danielLelescu/stitchmeter/assets/G25_Slides.pdf

EPFL — CONCEPTION DE MÉCANISMES II

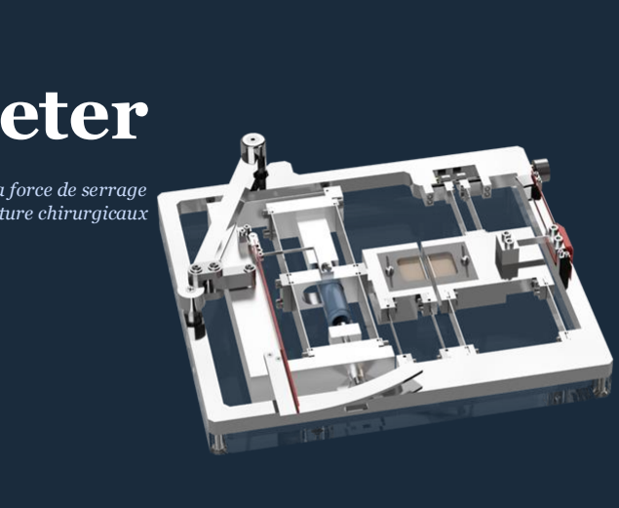
[picture p1: figure]

# StitchMeter

## Dispositif low-tech de mesure de la force de serrage et de la résistance des points de suture chirurgicaux

## Soutenance finale — Groupe 25

### Lucas De Boi · Honoré Specq · Daniel Lelescu

### Lilian Gardon · Titouan Beaux

Encadrement : Dr Simon Henein

20 mai 2026

# Notre but

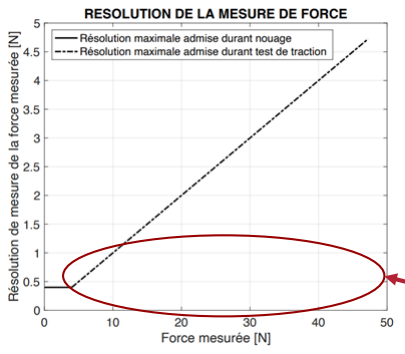
[picture p2: figure]
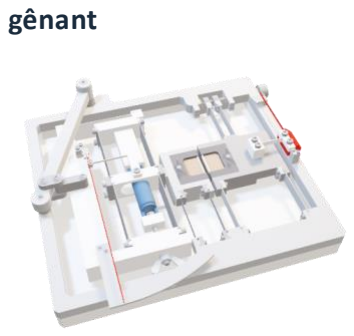
[picture p3: figure]
gênant

## On veut être ici

## - Cahier des charges

## - ΔFr < 10% Fmesure

## - Notre but

## - Résolution aussi fine que possible - Minimisation de toute erreur possible

## - Avantages: - Excellente résolution et précision - Lecture plus confortable, régulière et exploitable - Inconvénient: - dimensionnement stricte et encombrement plus

# Architecture générale du StitchMeter

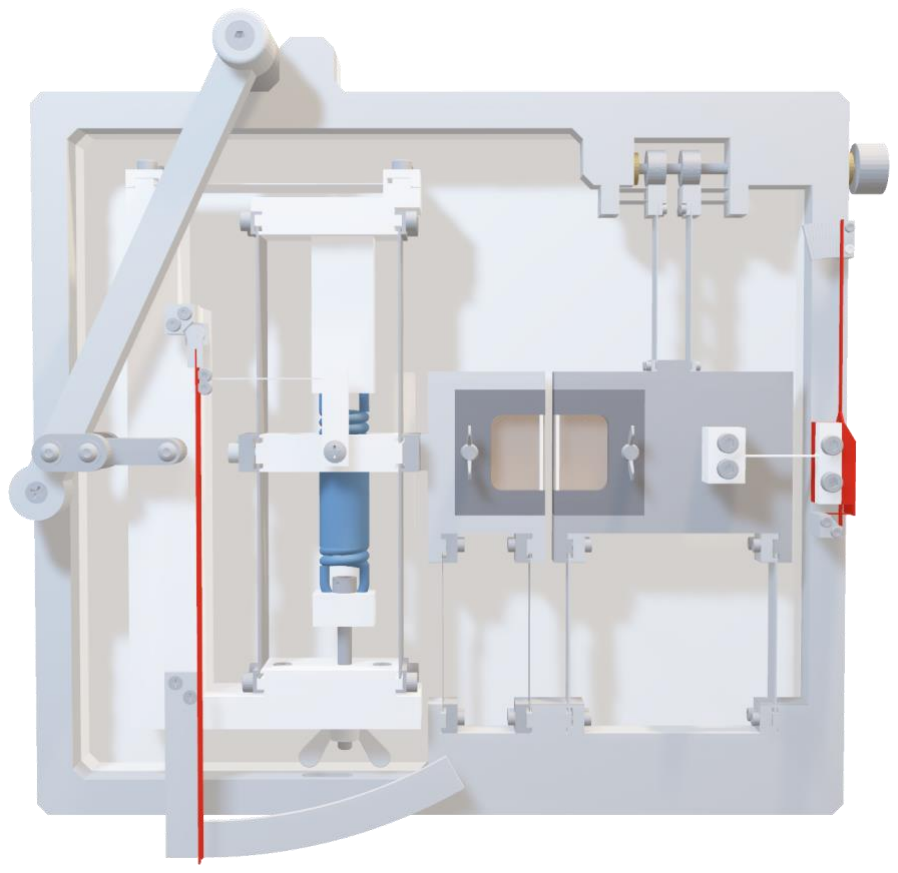
[picture p4: figure]

## Découplage des deux phases

## - Avantages - limite les interactions parasites entre les deux mesures - chaque phase peut être dimensionnée séparément selon son besoin principal - Inconvénient - plus encombrant et comporte deux sous-systèmes à intégrer

# Architecture générale du StitchMeter

Phase II | Phase I

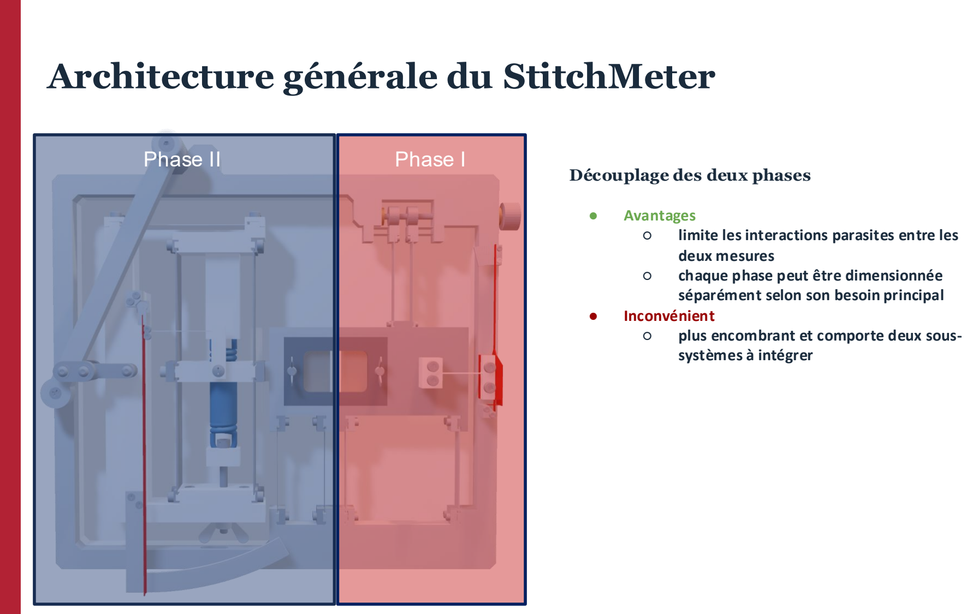
[picture p5: page 4]

## Découplage des deux phases

## - Avantages - limite les interactions parasites entre les deux mesures - chaque phase peut être dimensionnée séparément selon son besoin principal - Inconvénient - plus encombrant et comporte deux sous-systèmes à intégrer

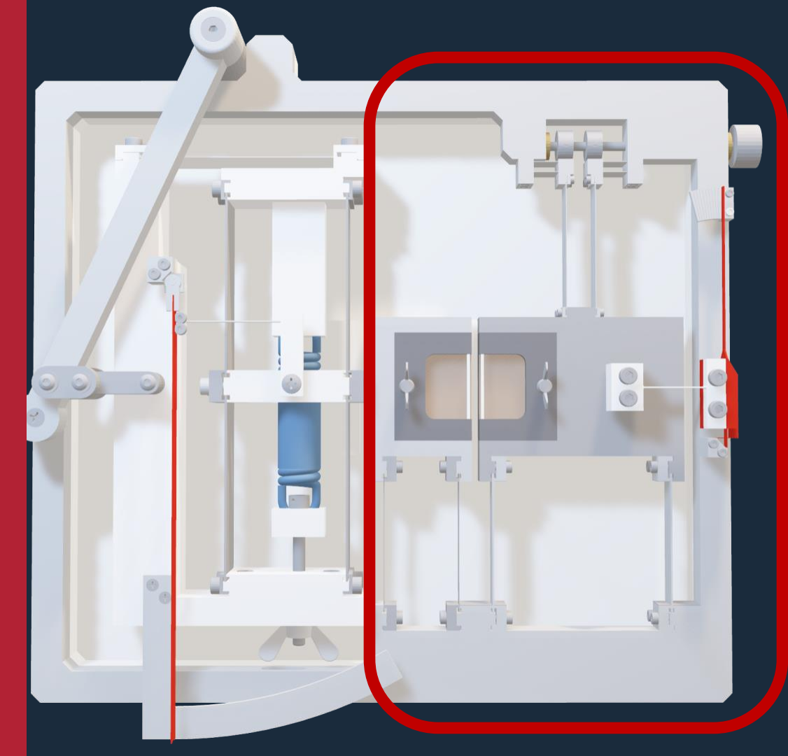
[picture p6: figure]

# Phase I

# Phase I

## Butées

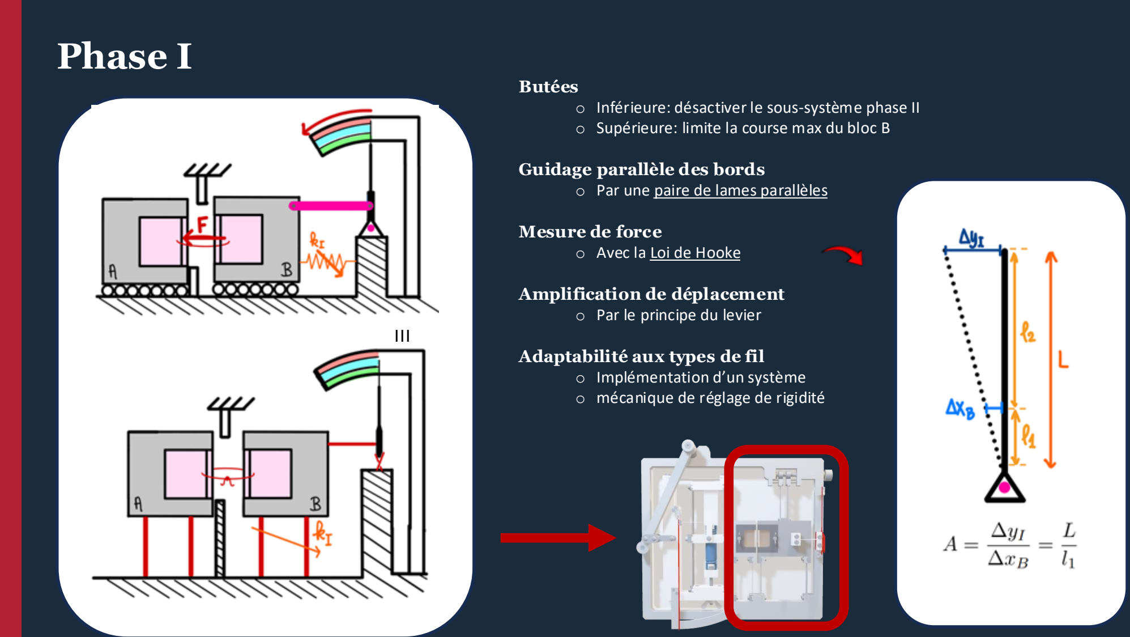
[picture p7: page 6]

## - Inférieure: désactiver le sous-système phase II - Supérieure: limite la course max du bloc B

## Guidage parallèle des bords

## - Par une paire de lames parallèles

## Mesure de force

## - Avec la Loi de Hooke

## Amplification de déplacement

## - Par le principe du levier

## Adaptabilité aux types de fil

## - Implémentation d’un système - mécanique de réglage de rigidité

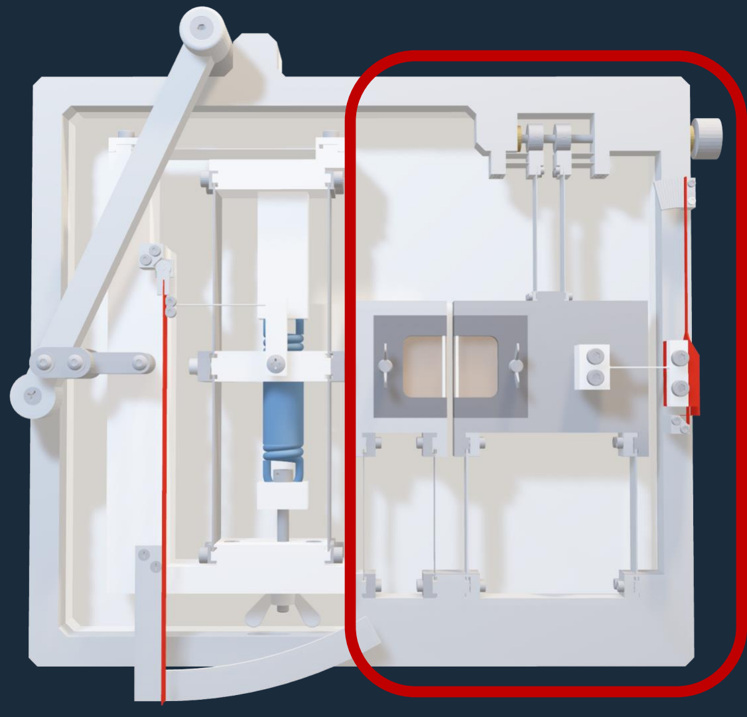
[picture p8: figure]

# Phase I

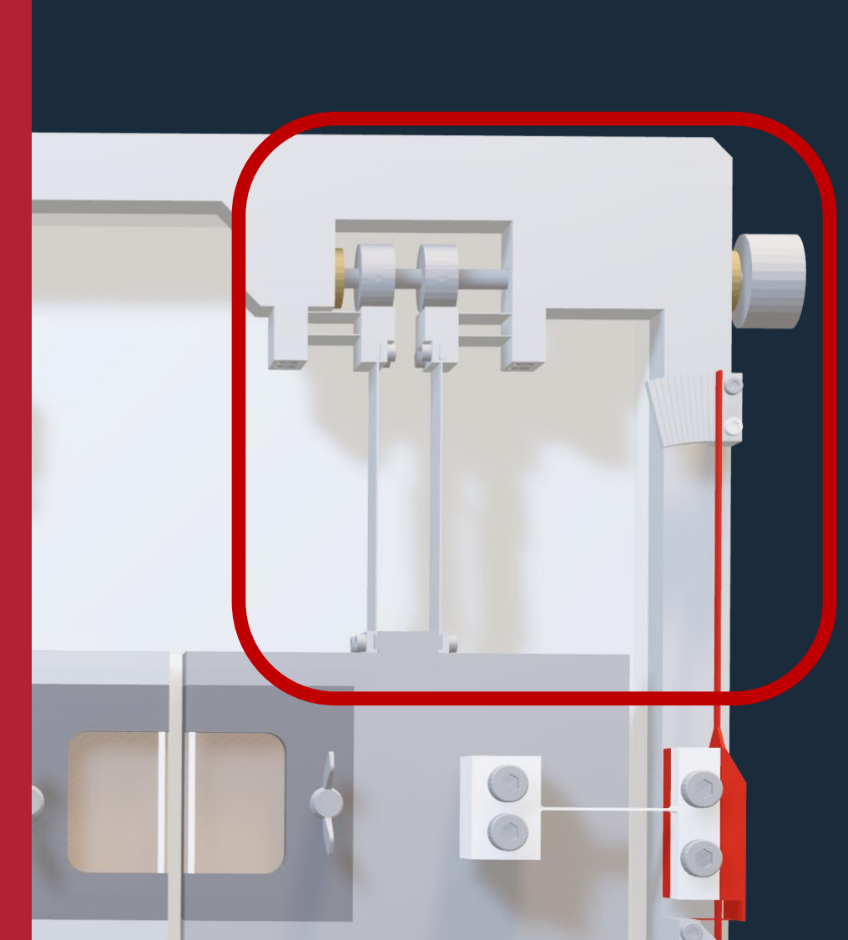
[picture p9: figure]

# Réglage de rigidité par flambage commandé

# Système de cames

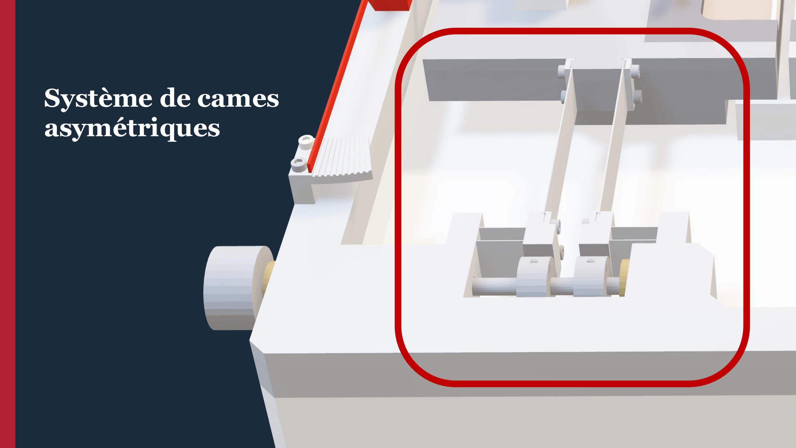
[picture p10: page 9]

# asymétriques

# Système de came asymétrique

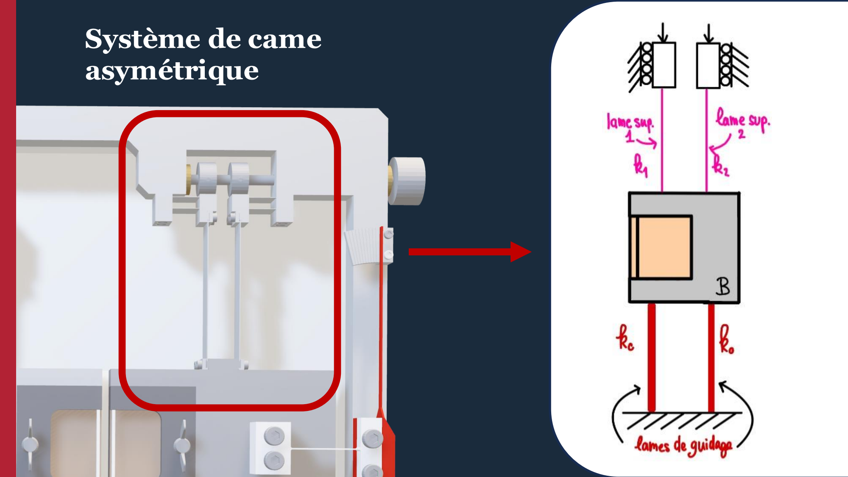
[picture p11: page 10]

# Réglage de rigidité par flambage commandé

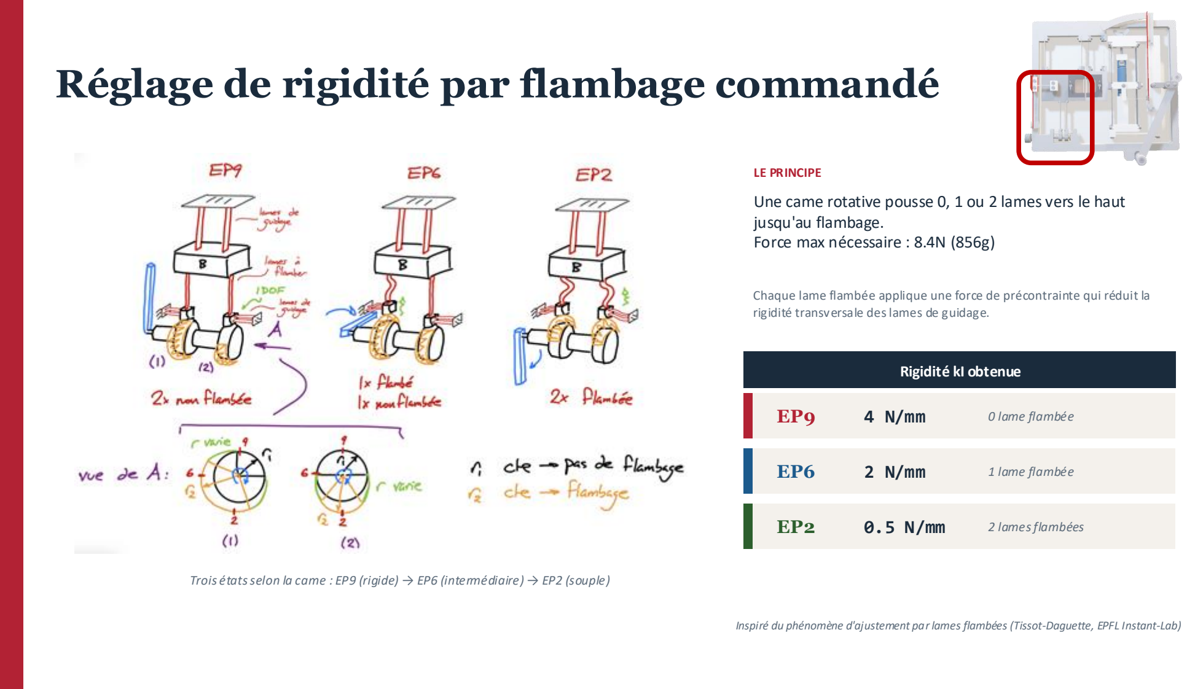
[picture p12: page 11]

Trois états selon la came : EP9 (rigide) → EP6 (intermédiaire) → EP2 (souple)

LE PRINCIPE

### Une came rotative pousse 0, 1 ou 2 lames vers le haut

jusqu'au flambage.

### Force max nécessaire : 8.4N (856g)

Chaque lame flambée applique une force de précontrainte qui réduit la rigidité transversale des lames de guidage.

### Rigidité kI obtenue

EP9 | 4 N/mm | 0 lame flambée
EP6 | 2 N/mm | 1 lame flambée
EP2 | 0.5 N/mm | 2 lames flambées

Inspiré du phénomène d'ajustement par lames flambées (Tissot-Daguette, EPFL Instant-Lab)

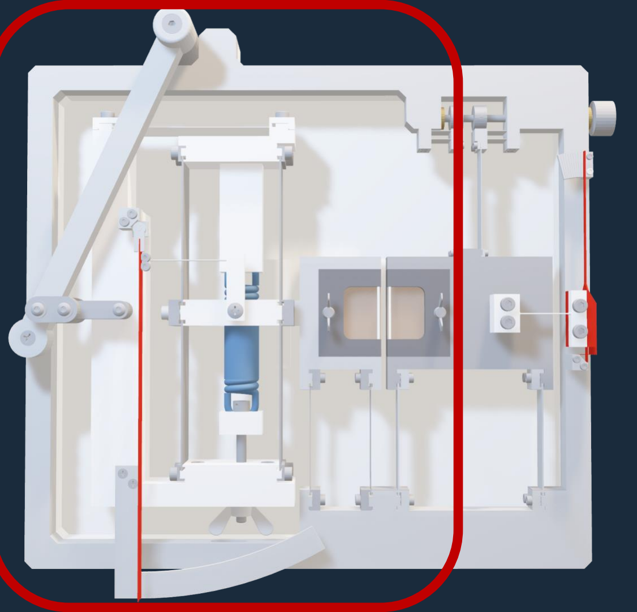
[picture p13: figure]

# Phase II

# Phase II

## Similitudes avec la phase I :

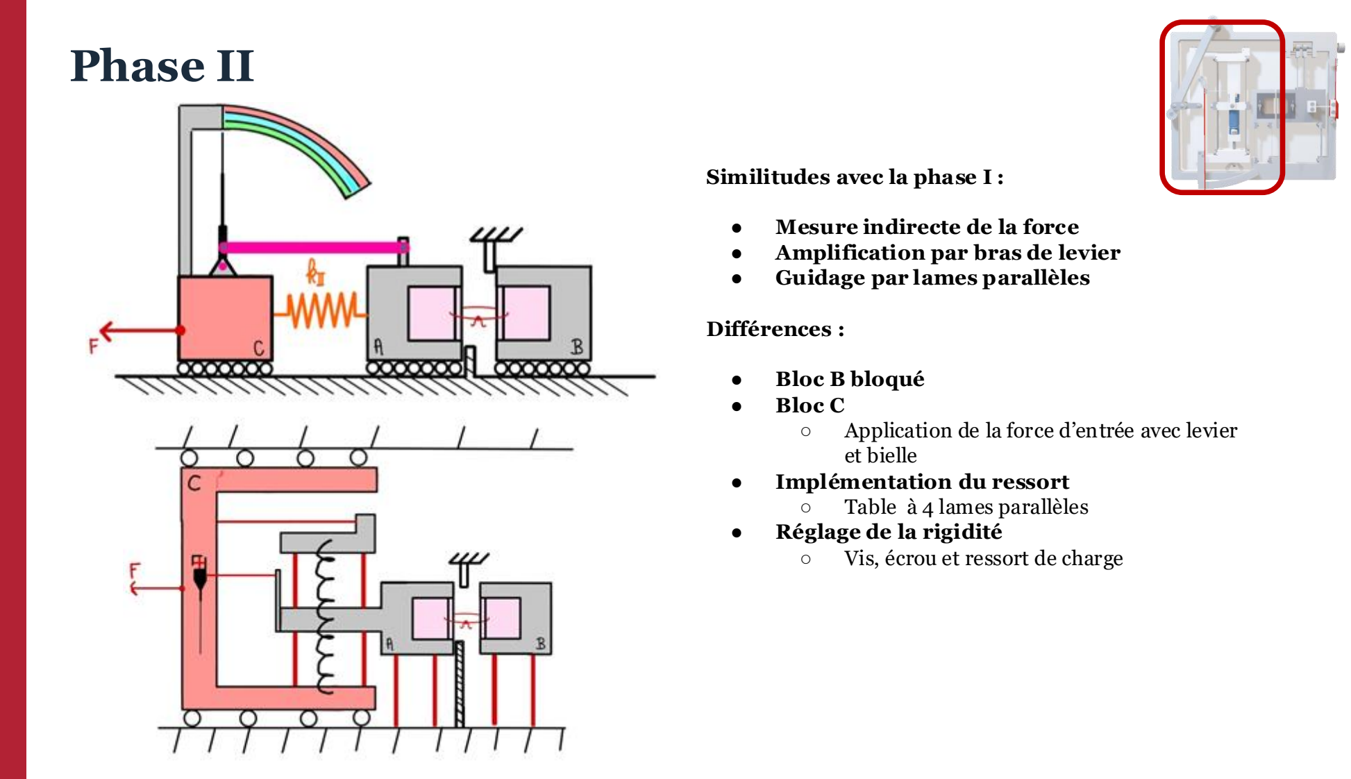
[picture p14: page 13]

## - Mesure indirecte de la force - Amplification par bras de levier - Guidage par lames parallèles

## Différences :

## - Bloc B bloqué - Bloc C - Application de la force d’entrée avec levier et bielle - Implémentation du ressort - Table à 4 lames parallèles - Réglage de la rigidité - Vis, écrou et ressort de charge

# Réglage de la rigidité : vis et écrou

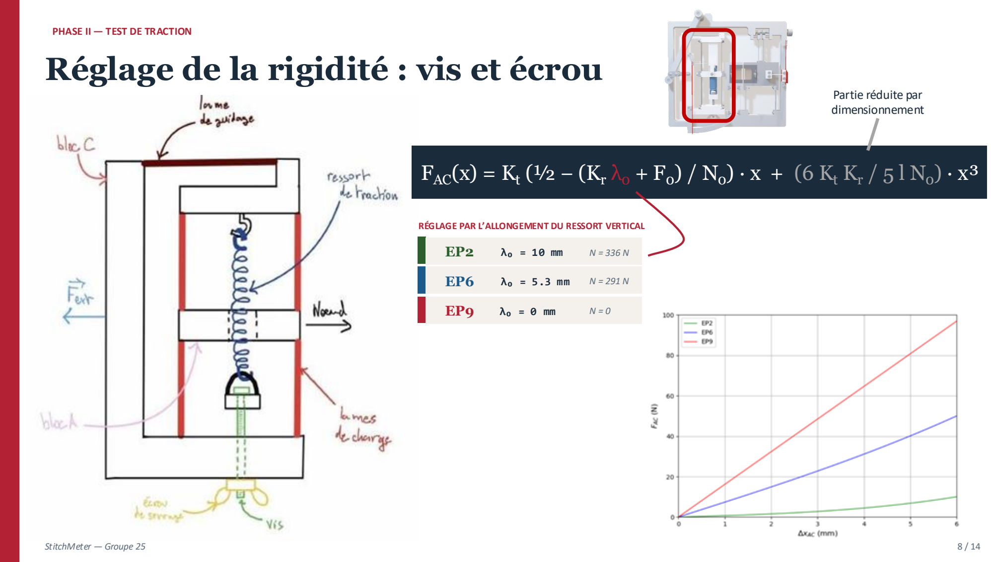
[picture p15: page 14]

PHASE II — TEST DE TRACTION

# FAC(x) = Kt

# (½ − (Kr λ0 + F0) / N0) · x + (6 Kt Kr / 5 l N0) · x³

RÉGLAGE PAR L’ALLONGEMENT DU RESSORT VERTICAL

EP2 | λ₀ = 10 mm | N = 336 N

EP6 λ₀ = 5.3 mm N = 291 N

EP9 λ₀ = 0 mm N = 0

StitchMeter — Groupe 25 | 8 / 14

### Partie réduite par dimensionnement

# Résolution de mesure phase II

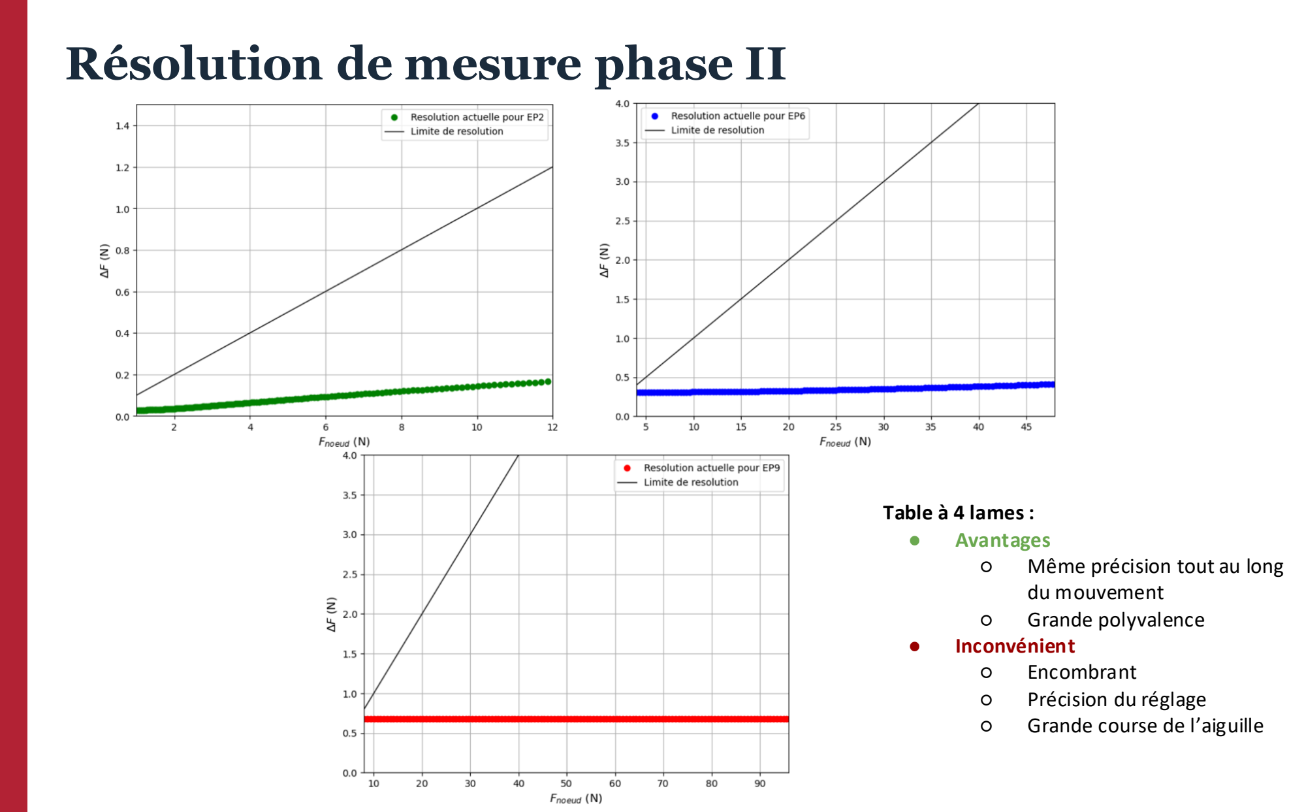
[picture p16: page 15]

## Table à 4 lames : - Avantages - Même précision tout au long du mouvement - Grande polyvalence - Inconvénient - Encombrant - Précision du réglage - Grande course de l’aiguille

# L'Ensemble du Système

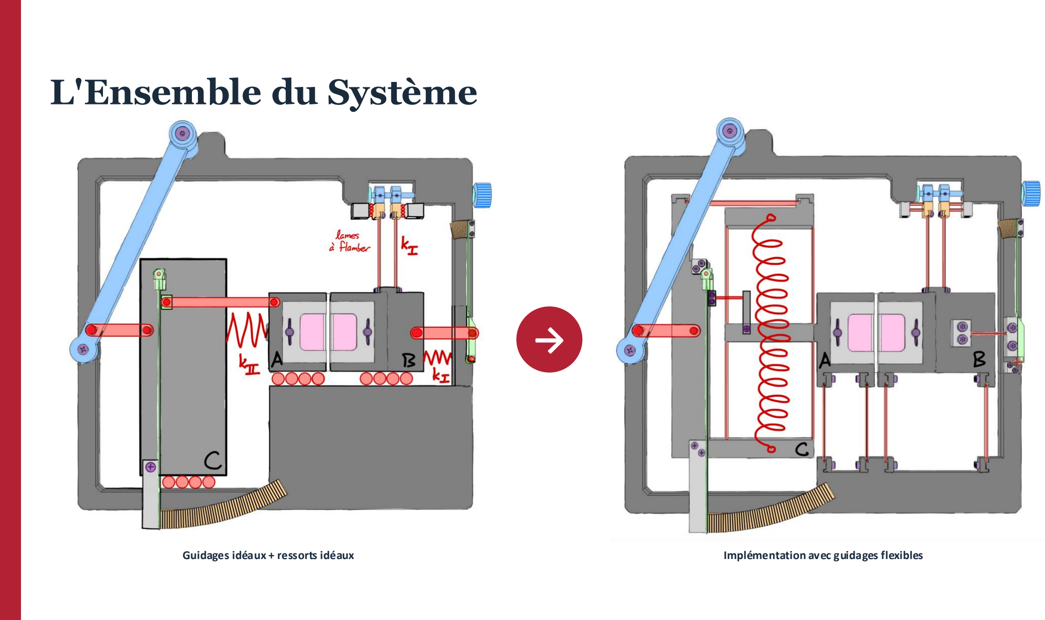
[picture p17: page 16]

Guidages idéaux + ressorts idéaux | Implémentation avec guidages flexibles

→

CONSTRUCTION

# Quatre matériaux

## Aluminium 7075 (Perunal-215)

Structure principale, lames de guidage

Léger, usinable, peu coûteux. Suffisant presque partout — pas besoin d'acier.

## Acier Böhler K190

Came, arbre, ressort AC

Haute résistance et résistance à l'usure pour les interfaces frottantes hors chaîne de mesure.

## Titane 6Al-4V

Aiguille de mesure Phase II

Meilleur rapport σ_D / E (0.0045) → maximise la course angulaire (30°) du pivot croisé.

## Polycarbonate (PC)

Plaques de boîtier, butées

Léger, transparent, peu coûteux, mais très résistant. Permet de voir le mécanisme sans le démonter.

TENUE EN FATIGUE

# Contraintes worst-case dans les éléments flexibles

Tous les éléments flexibles tiennent les 10⁵ cycles requis, avec un facteur de sécurité ≥ 1.

Élément | Matériau | σ_max (basé @ 10⁷
) | σ_adm @ 10⁵ | FS
Pivot aiguille Phase I | Alu 7075 | 145 MPa | 225 MPa | 1.5
Pivot aiguille Phase II | Ti-6Al-4V | 500 MPa | 600 MPa | 1.2
Lames guidage Bloc B | Alu 7075 | 143 MPa | 225 MPa | 1.6
Lames guidage Bloc A | Alu 7075 | 108 MPa | 225 MPa | 2.0
Lames, Ressort AC | Acier K190 | 740 MPa | 1100 MPa | 1.49

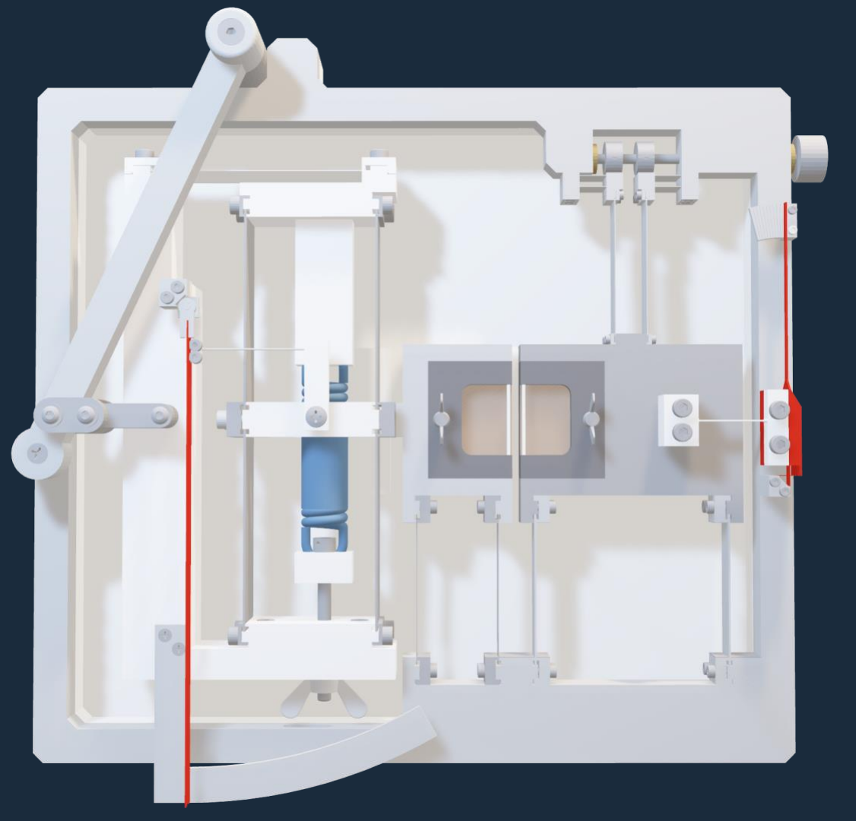
[picture p18: figure]

# Assemblage

# Système levier + bielle

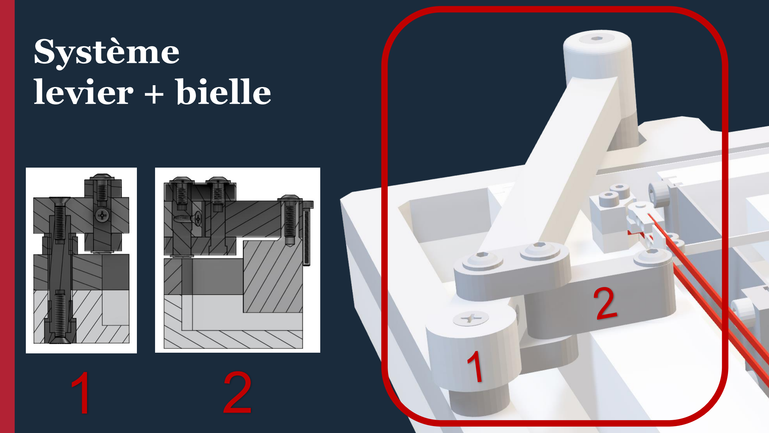
[picture p19: page 20]

1 2

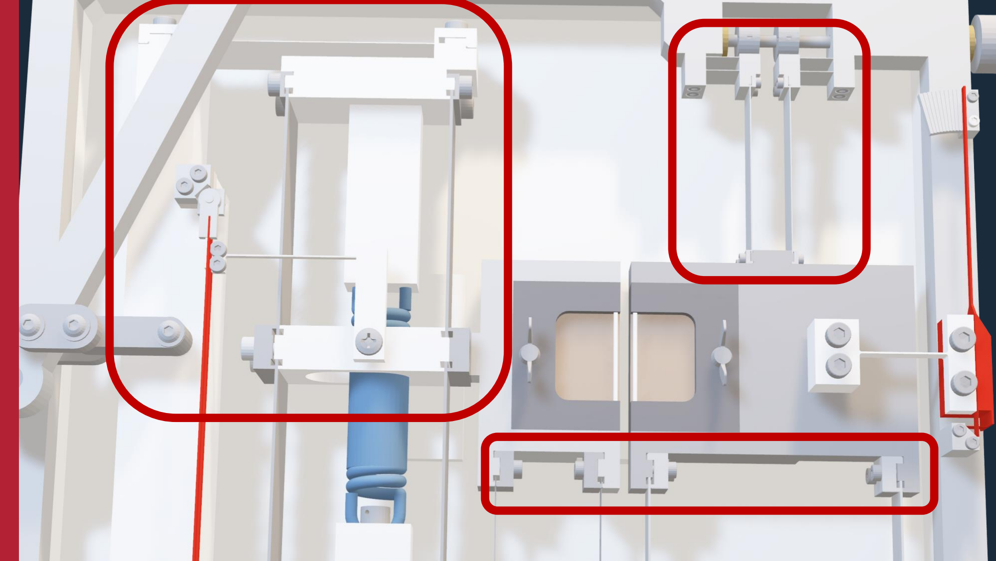
[picture p20: page 21]

# Maintenance facilitée

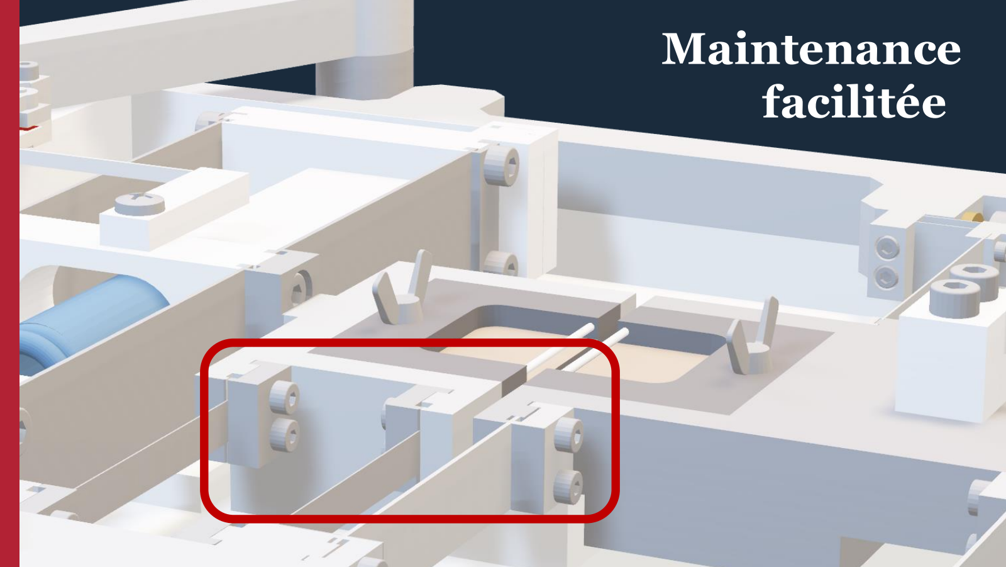
[picture p21: page 22]

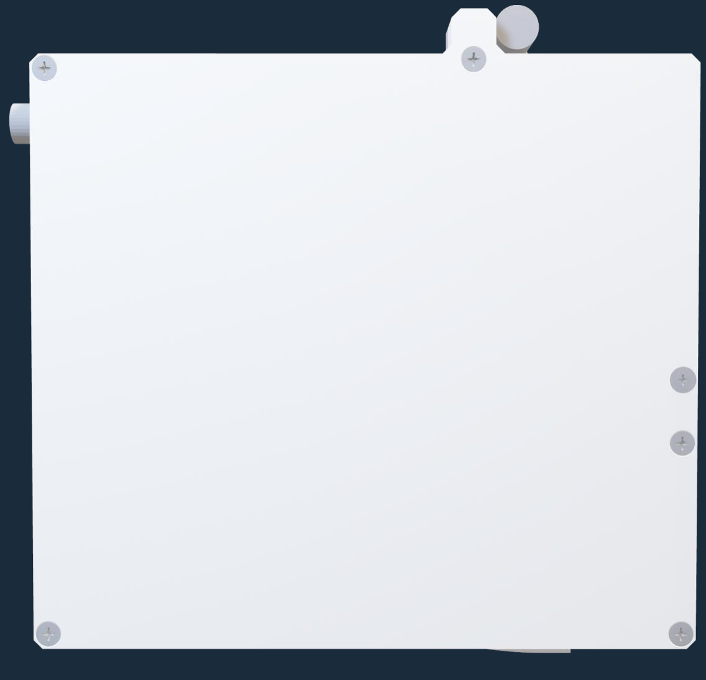
[picture p22: figure]

# Maintenance facilitée

# Maintenance facilitée

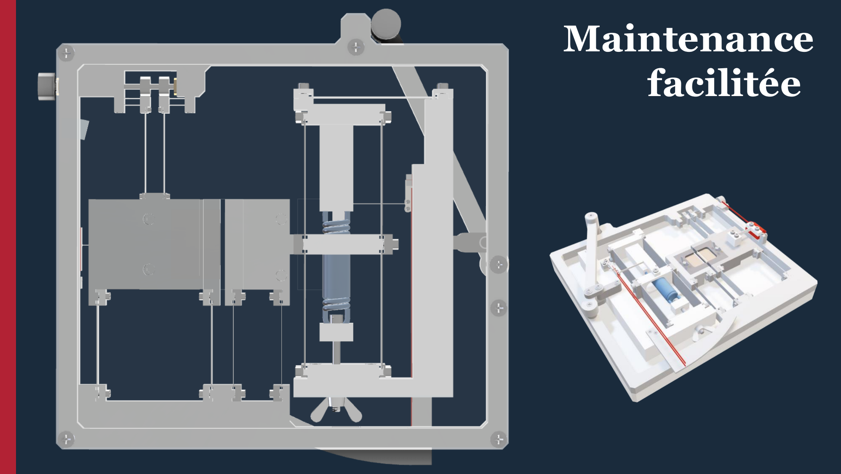
[picture p23: page 24]

# Procédés d’usinage

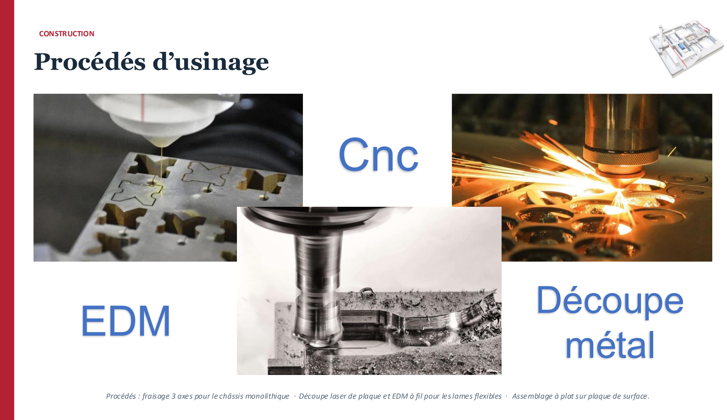
[picture p24: page 25]

CONSTRUCTION

Procédés : fraisage 3 axes pour le châssis monolithique · Découpe laser de plaque et EDM à fil pour les lames flexibles · Assemblage à plat sur plaque de surface.

# Cnc

EDM | Découpe métal

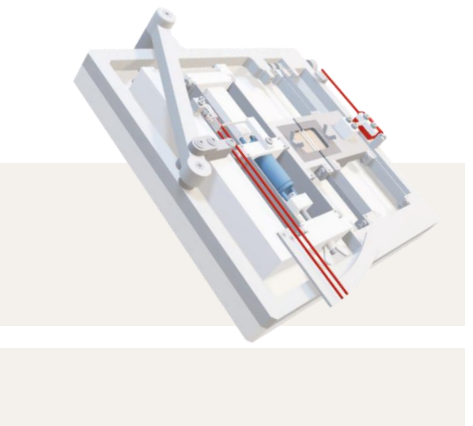
[picture p25: figure]

DISCUSSION

# Sources d'erreur et limites identifiées

## Inclinaison du dispositif

À 30° autour de l'axe X : effet négligeable sur la rigidité (Δk ≤ 0.05 N/mm).
À 30° autour de l'axe Y : décalage du zéro important (y_err = 211 mm) → utilisation horizontale recommandée.

## Couplage Phase I / Phase II

En début de Phase II, tant que F < 0.1·F_nom, les deux ressorts travaillent en parallèle. L'erreur est récupérable en lisant les deux aiguilles, mais reste une limite si lue seule.

## Relaxation du nœud

Compensée par la mesure relative entre blocs A et C (règle solidaire de C).
Erreur résiduelle due à kA · xA : ≤ 0.36 N, soit < 3 % de la mesure à pleine échelle. Erreur : EP2 < 4 graduation, EP6 < 1 graduation, EP9 <<< 1 graduation donc invisible.

Aucune non-conformité avec le cahier des charges — pas de calibration, un montage correct donne un système calibré.

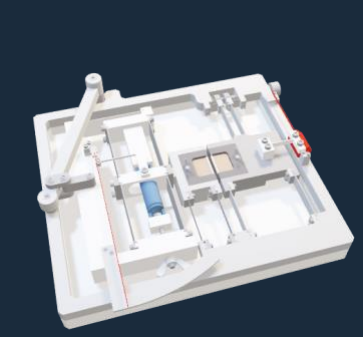
[picture p26: figure]

### CONCLUSION

Un StitchMeter robuste, lisible, entièrement mécanique.

## 01 Toute la chaîne de mesure repose sur des éléments flexibles

Aucun frottement entre la force du nœud et la lecture de l'aiguille.

## 02 Un seul dispositif couvre EP2, EP6 et EP9

Flambage discret (Phase I) + ressort vertical réglable (Phase II).

## 03 Résolution conforme et quasi-constante

ΔF ≤ 10 % de la mesure sur toute la plage, pour les trois fils.

04 Robuste, low-tech, sans calibration,

## modulable

Compatible avec une utilisation en zone sinistrée. Tenue garantie : 10⁵ cycles.

Merci pour votre attention. | Questions ?
