danielLelescu/stitchmeter/assets/G25_CAD.jpg

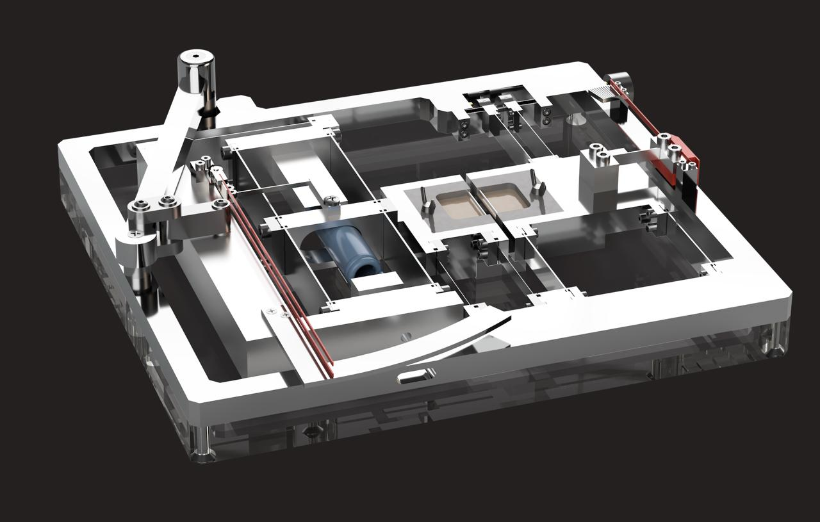
assets/G25_CAD.jpg
