danielLelescu/stitchmeter/assets/planche1.jpg

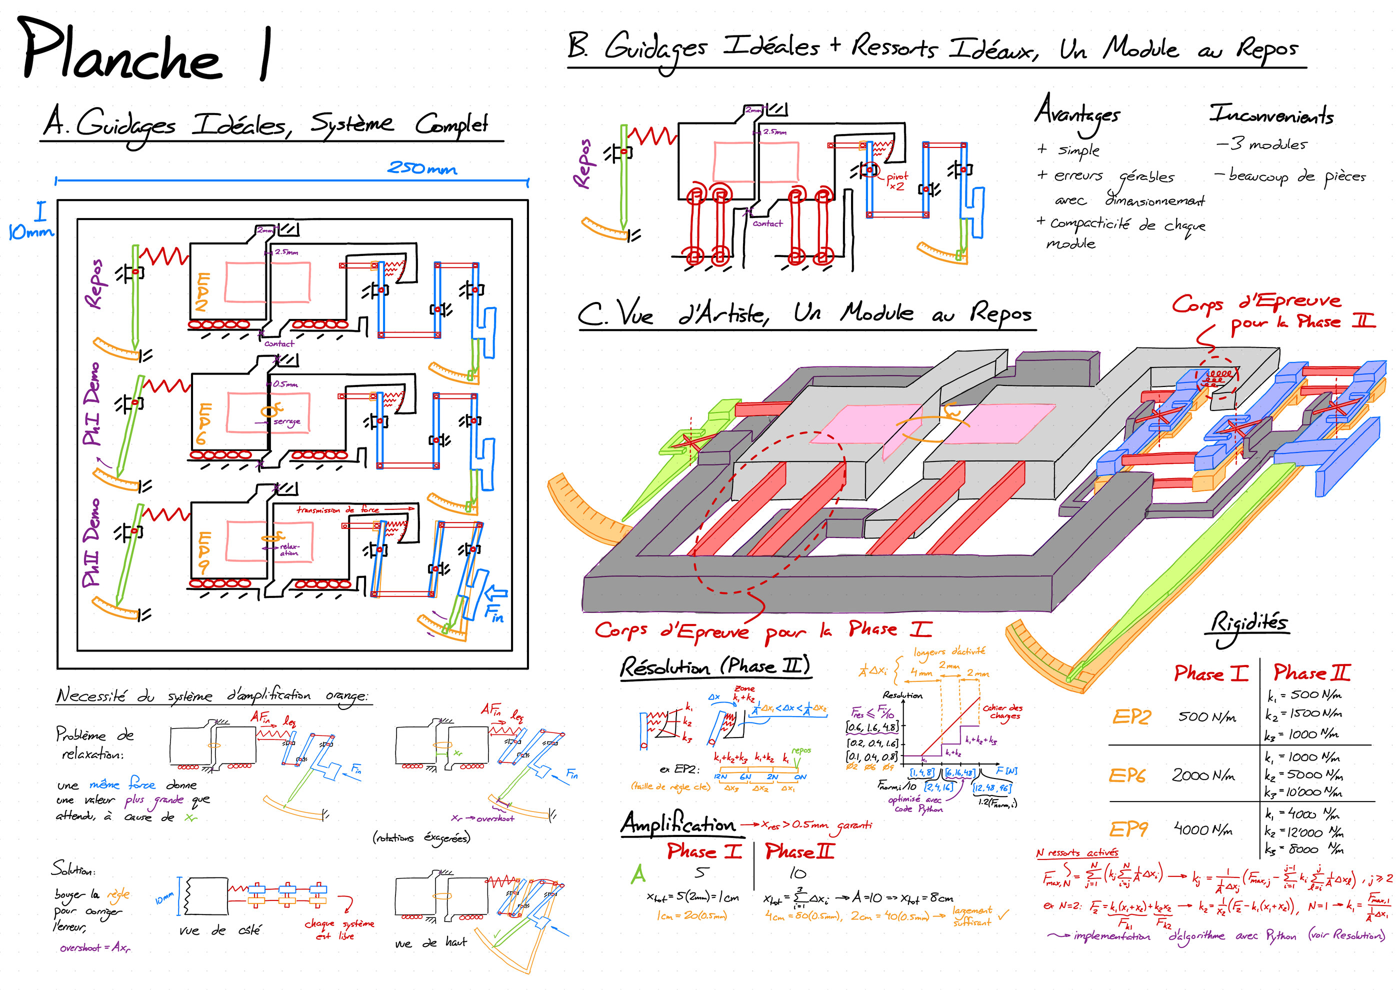
assets/planche1.jpg
