danielLelescu/stitchmeter/assets/schema-flex.png

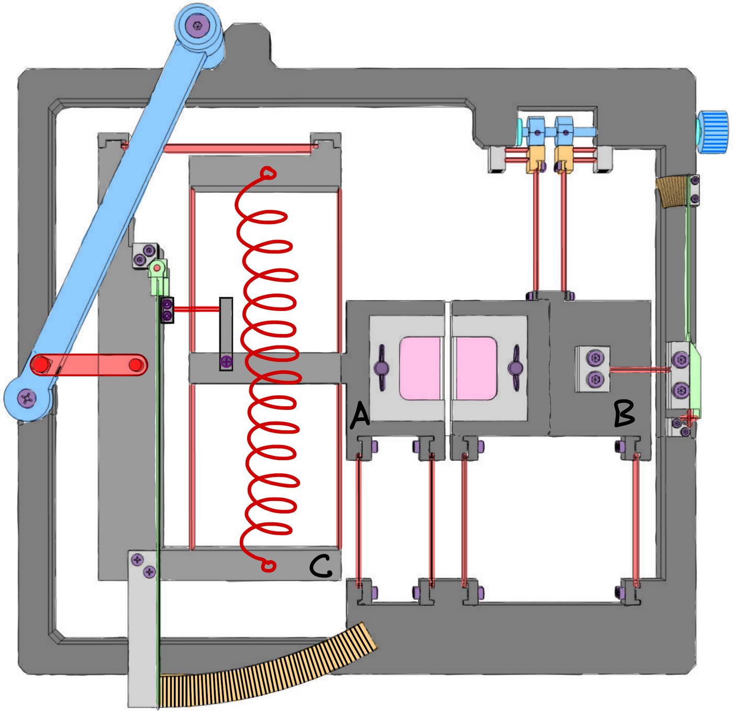
assets/schema-flex.png
