danielLelescu/stitchmeter/assets/schema-ideal.png

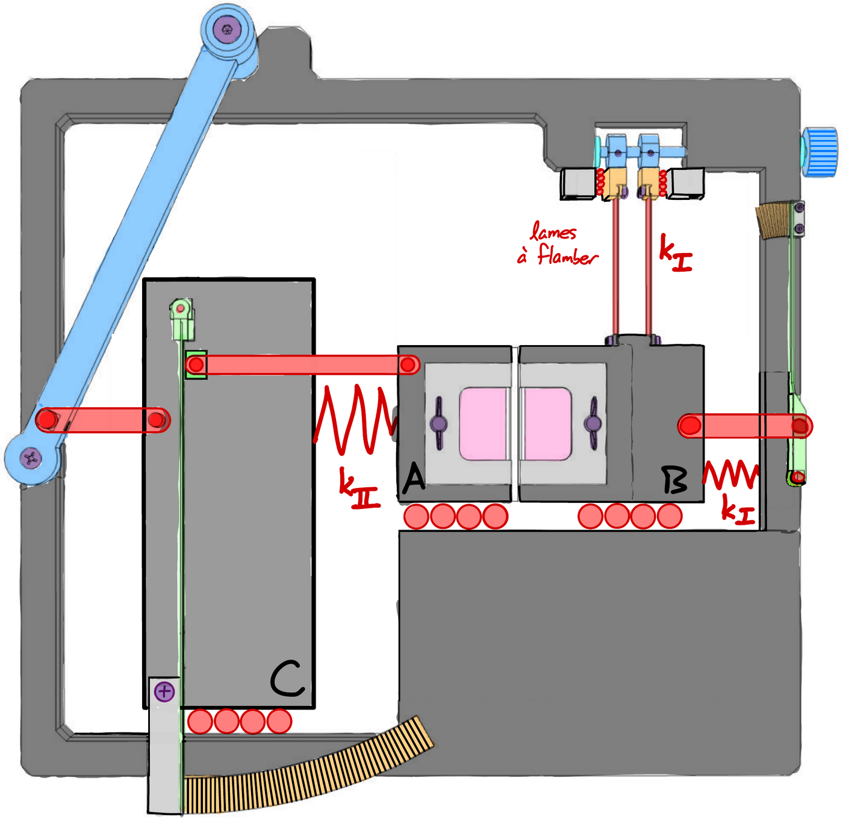
assets/schema-ideal.png
