danielLelescu/stitchmeter/cad/G25_Stitchmeter.step

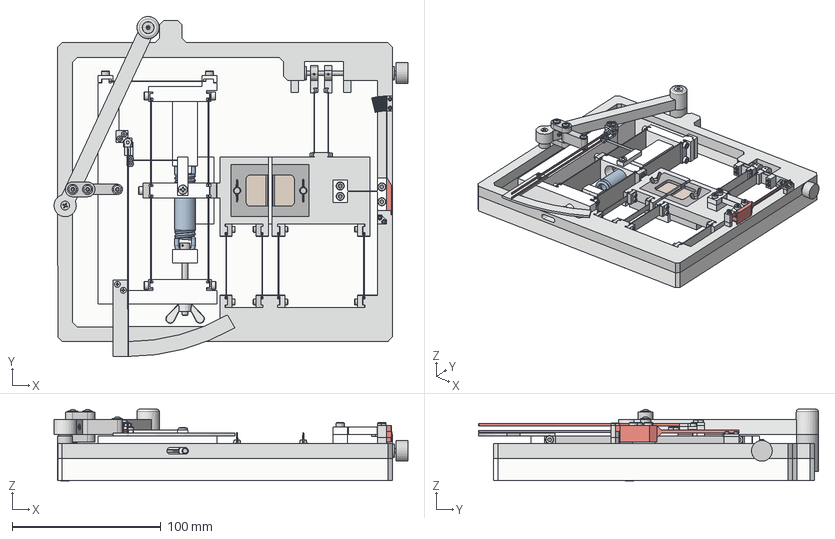
[picture p31: CAD file, 2026-08-28]
cad/G25_Stitchmeter.step
238.0 x 228.6 x 48.1 mm
ph2_block
DIN 912 - M3 x 0.5 x 12 Steel 4.6 Plain x 4
aiguille_spacer
ph1_block
Hexagon Socket Head Cap Screw DIN 912 - M3 x 0.5 x 8 Steel 4.6 Plain v1 x 14
chassis
aiguille_ph2
Buckling mecanism_2N x 2
levier_haut
fond_boite
BHSFCHCS ANSI B18.3.5M - M4x30 Acier de classe 2 Standard
blade_2N
blade_lock x 4
blade_1.5N
DIN 912 - M1.4 x 0.3 x 3 Steel 4.6 Plain x 4
DIN 912 - M1.4 x 0.3 x 4 Steel 4.6 Plain x 4
lame_guidage x 2
Blade_lock_bas x 4
DIN 912 - M2 x 0.4 x 6 Steel 4.6 Plain x 16
DIN 912 - M1.6 x 0.35 x 8 Steel 4.6 Plain x 4
arbre a came
clinquant x 2
came
came_short_edge
ISO 7046-2 - M4x20 - H Acier 4.6 Standard x 5
réglette_ph2
DIN 912 - M1.4 x 0.3 x 10 Steel 4.6 Plain x 2
DIN 912 - M1.6 x 0.35 x 16 Steel 4.6 Plain x 2
aiguille_trainante_ph2
DIN 965 - M3 x 20 - H Acier 4.6 Standard
lame_ph2 x 2
Blade_lock_bas_ph2 x 4
palier_lisse_levier x 2
arbre_levier
levier_bas
bloc_peau x 2
DIN 318 - M3 x 12 Steel 4.6 Plain x 2
anneau_levier
attache_boite_levier
lame_rigidité_variable
lame_honore x 4
plaque_1_honoré x 4
honoré_block
honoré_block_droite
CS JIS B 1111 - M3x12 - H Acier 4.6 Standard
CS JIS B 1111 - M2x10 - H Acier 4.6 Standard x 2
BSHCS ASME B18.3.1M - M2x0.4 x 16 Acier de classe 2 Standard x 2
spacer_bloc_A
arbre_bielle_levier
CS JIS B 1111 - M3x14 - H Acier 4.6 Standard
CS JIS B 1111 - M2x8 - H Acier 4.6 Standard
DIN 912 - M3 x 0.5 x 16 Steel 4.6 Plain x 2
biellette
arbre_biellette_2
bielle_levier
biellette_1
JIS B 1251 - B 3 Acier 100 HV Standard
PN-EN ISO 7380-2 - M3 x 10 Acier 4.6 Standard
PN-EN ISO 7380-2 - M3 x 6 Acier 4.6 Standard x 2
BHSFCHCS ANSI B18.3.5M - M3x12 Steel Grade 2 Plain x 2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
