danielLelescu/stitchmeter/assets/CdM Schema Flex.pdf

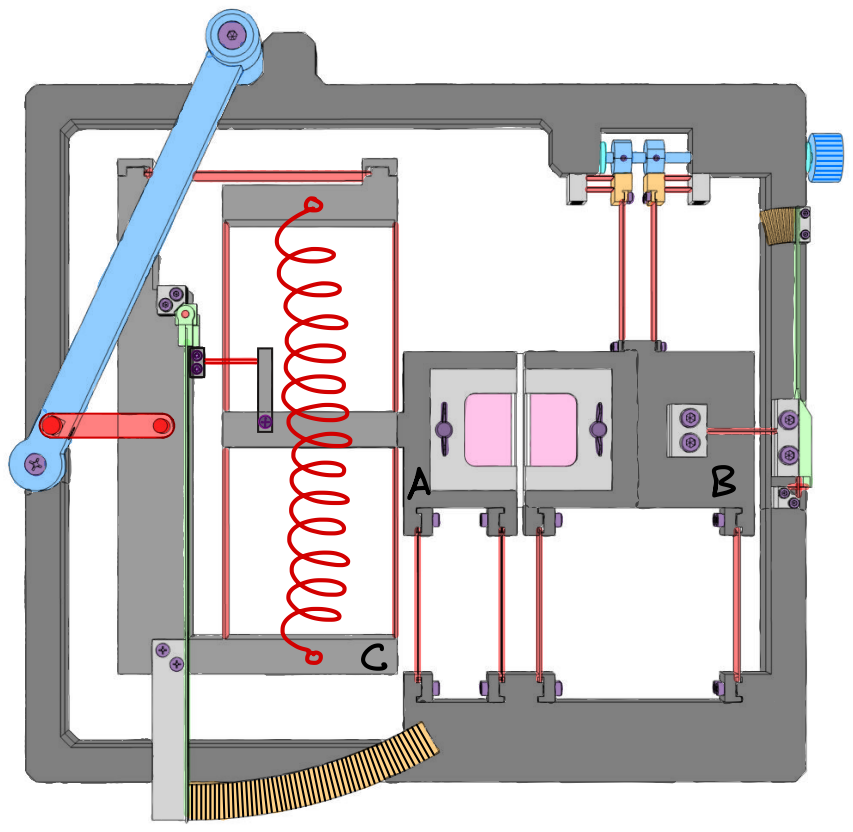
[picture p32: page 1]
