danielLelescu/stitchmeter/assets/CdM Schema Ideal.pdf

I I

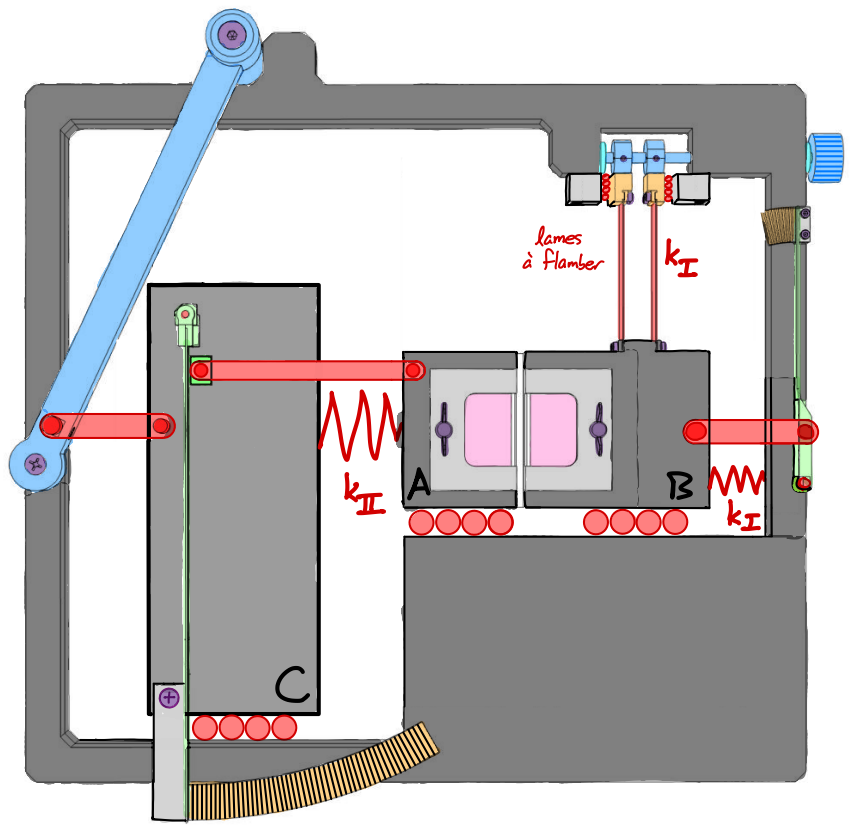
[picture p33: page 1]
lames; a flamber
