danielLelescu/stitchmeter/docs/G25_Planche1.pdf

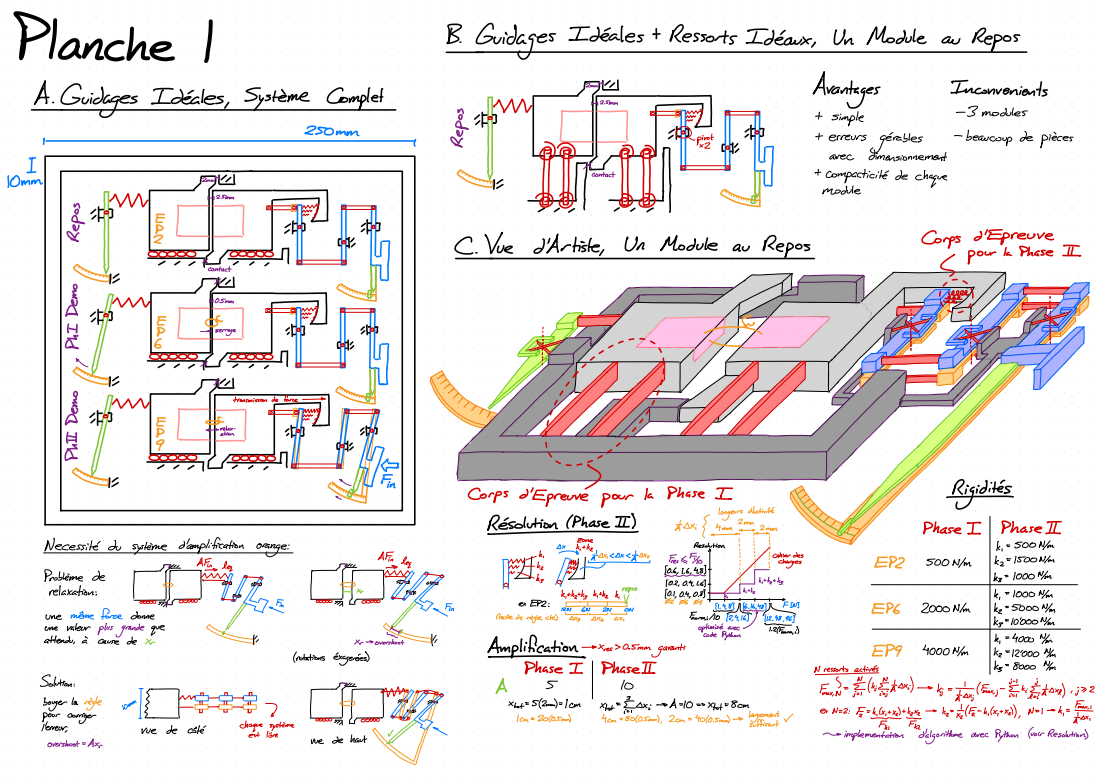
[picture p34: page 1]
· & PhIDemo & Repos #e S e & & 3 S &ITI HO · & r ↑Y
