danielLelescu/stitchmeter/docs/G25_Planche2.pdf

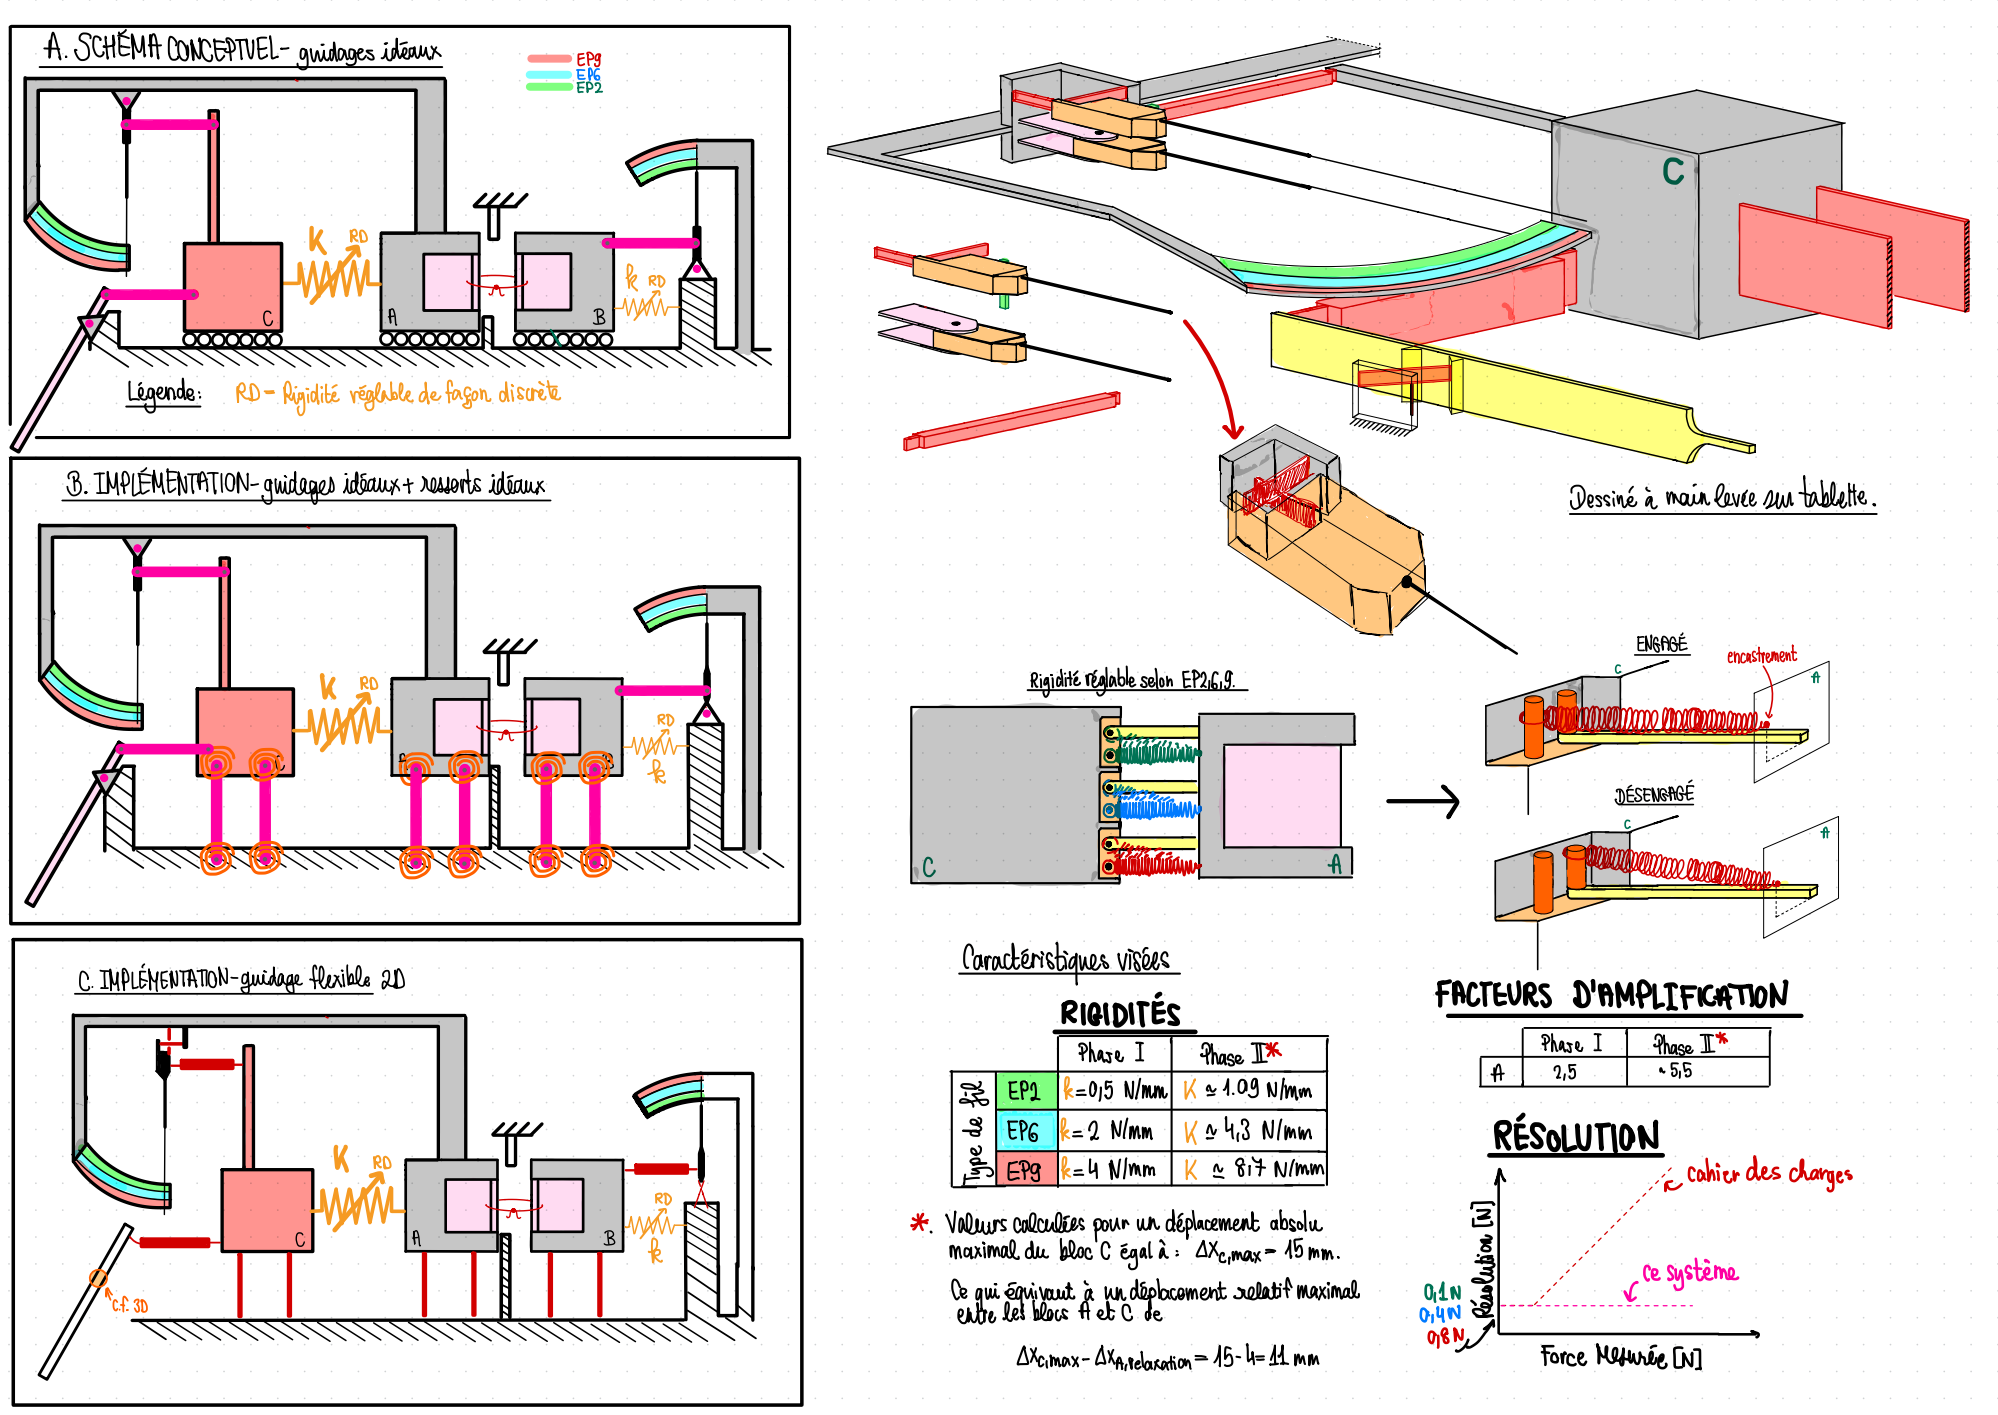
[picture p35: page 1]
いいいnnu; / ∞ ## star เร#; ‰ ggl; =Starte!; ·propert ·; !Previou; #mmme #IaeenmmEr; mnmmmmmm; iDX

℃ mnmmmmmm mmmm in
