danielLelescu/stitchmeter/docs/G25_Planche3.pdf

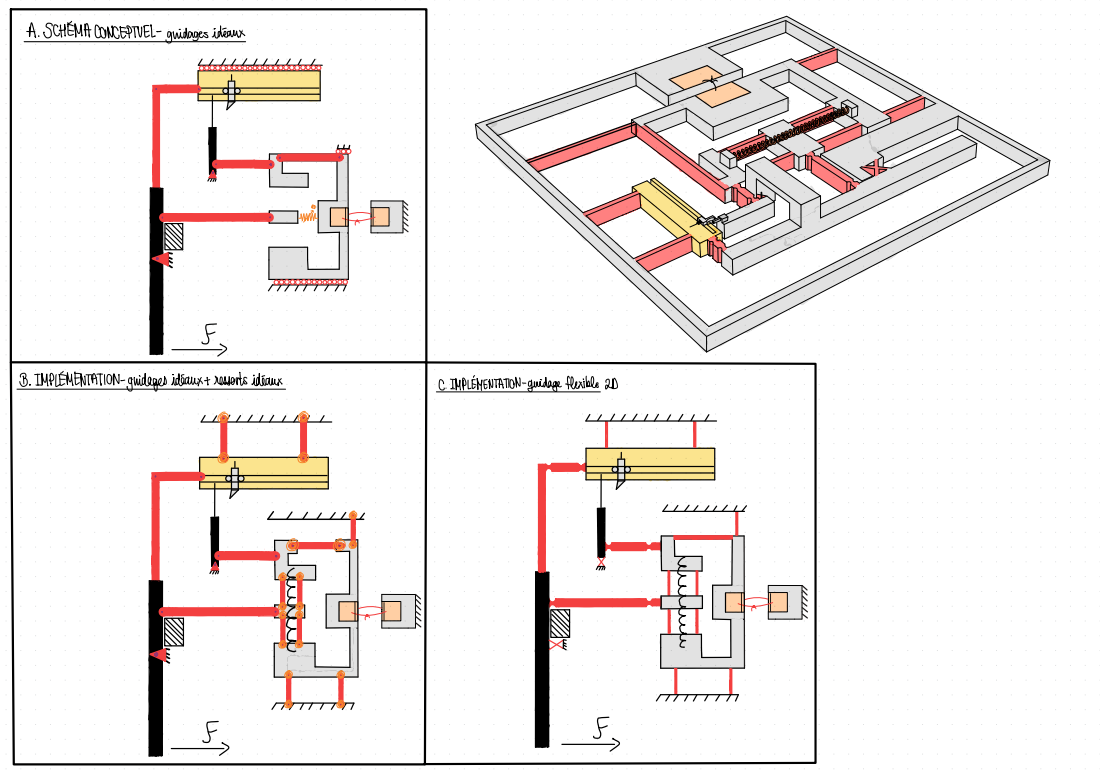
[picture p36: page 1]
Mㅱ √ว .- ' ไ * " · · "e - : min· - ← ←; · emm; ร mmpemmmm; · munu · ⑧; ·m mmpan

·함ร ^ maorM mmpnm · .
