danielLelescu/stitchmeter/docs/G25_Planche4.pdf

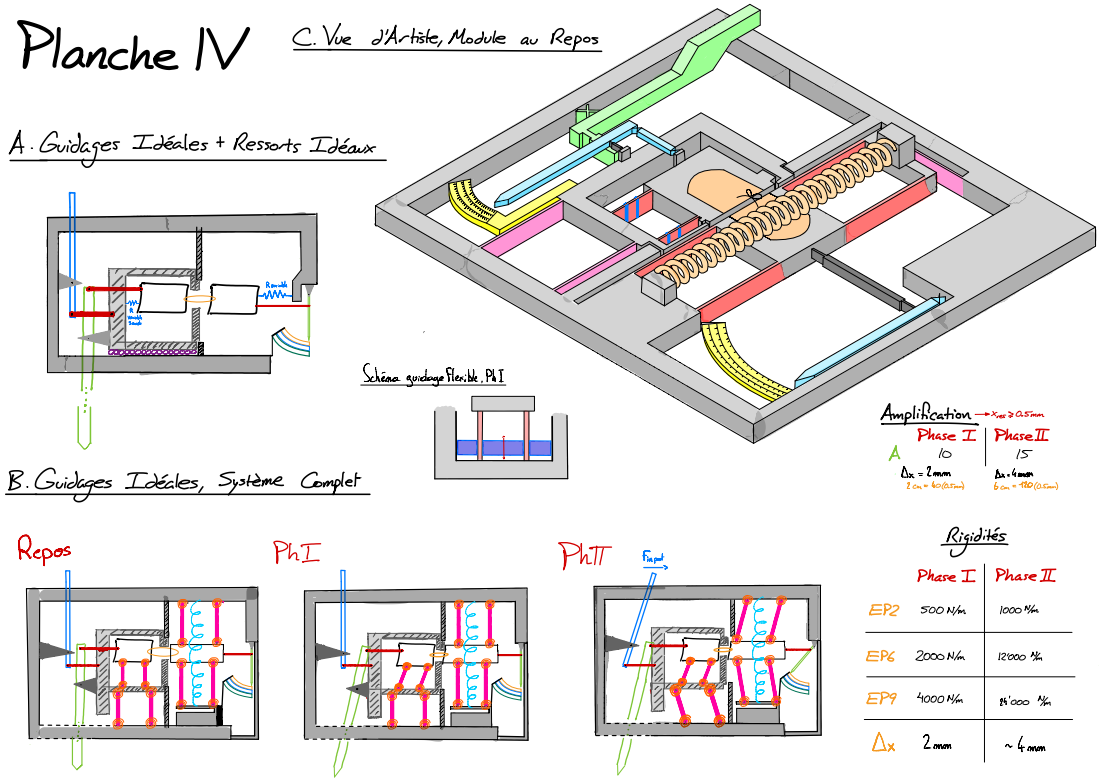
[picture p37: page 1]
weuke; แรงงานนา U; : 驀針驀queー . เล รั
