danielLelescu/stitchmeter/docs/G25_planche5.pdf

E

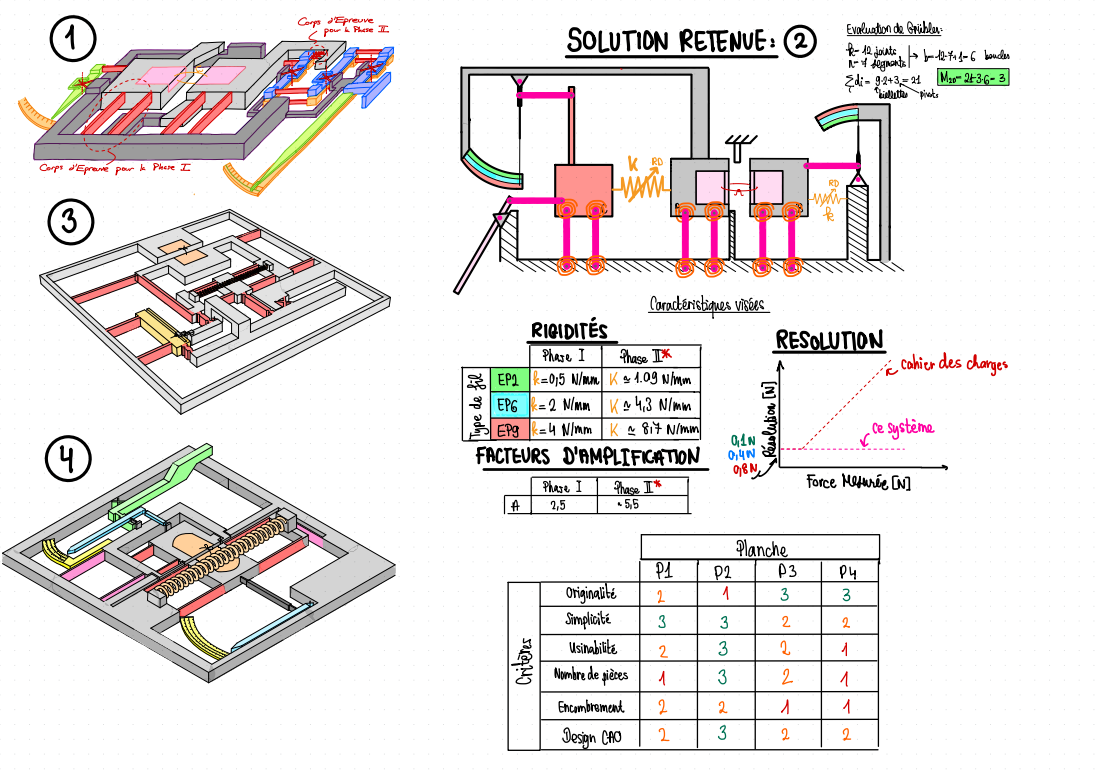
[picture p38: page 1]
Corps d'Epreuve π; Evaluation de Grübler:; 5 pour la Phase _; SOLUTION RETENUE :; k=12joints e> b=12-7+ 1=; 6 boncles; 7 segments; ↑billettes; pivots; lsI ≠; morrveemnhnoramrs ^; Caractéristiques visées; RIGIDITÉS; RESOLUTION; Phase I; Phase#*; EPG k= 2 NImm ㅣ K1 4,; 3 Nimm; 09 NImm; EPg k=4 Nimm; k 1 817 Nimm; ce système; FACTEURS D'AMPLIFICATION; Phase µ; Force Mesurée [N] \ A 2, g; / Phase*; Planche; ply 嬥籠籠; originalité; Simplicité; usinabilite; = Nombre de pièces; Encombrement; Design CAO

Cahier des charges
