danielLelescu/stitchmeter/(commit log)

2026-09-10 Add CAD showcase, schema comparison, and design board to project page
    - New showcase section: G25_CAD.jpg full width between the hero and
    Project at a glance.
    - "How the system works" now shows the ideal kinematic schema and the
    flexure implementation side by side with an arrow between them, over
    an explanation block. Both images link to their source PDFs.
    - "What changed / what worked" now leads with an explanation block
    followed by Planche 1 at full width, linking to the full-resolution
    PDF in docs/.
    Schema and planche images are rasterised from the PDFs (400 and 250 dpi)
    so they can be displayed inline; both schemas share one crop box so they
    sit at the same scale.
    Co-Authored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
2026-09-10 Add .gitignore for OS, editor, Python, and CAD scratch files
    Claude-Session: https://claude.ai/code/session_014VkhKe3xKiF1j76LVEnMf6
2026-09-11 Add slides and CAD links, team credits, and a contact section
    - Two more documentation cards: the presentation .pptx and the STEP
    assembly, alongside the report PDF and the pitch video.
    - Team and contributions as a collapsed details dropdown at the bottom
    of the documentation section.
    - Contact band with Back to portfolio and Contact links, plus a Contact
    entry in the project nav.
    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
2026-09-12 Make the two schema images non-clickable
    The anchors around the ideal and flexure schemas had empty hrefs, so
    clicking an image reloaded the page. Replaced them with plain figure
    frames; the schemas are now static. Planche 1 keeps its PDF link.
    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
